mikew123/roborama25_ws/3dprinting/Roborama2025-CamMount.amf

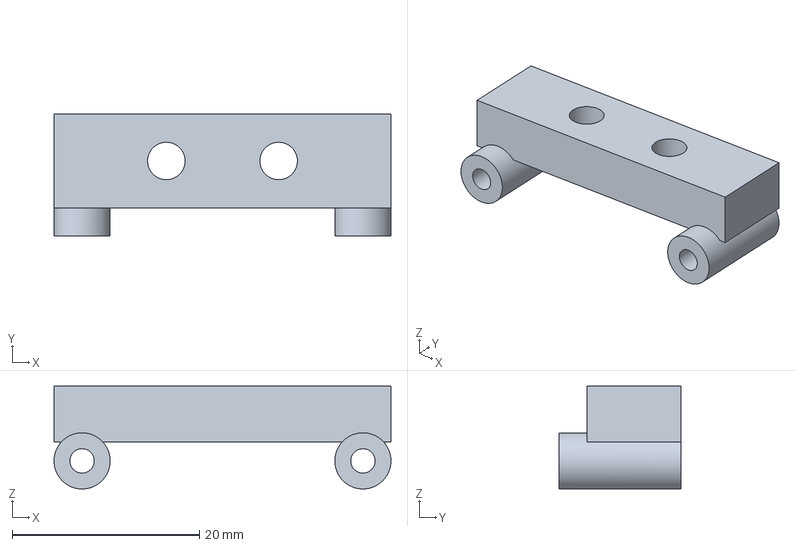
[picture p7: CAD file, 2025-03-17]
3dprinting/Roborama2025-CamMount.amf
36.0 x 13.0 x 11.0 mm
