mikew123/roborama25_ws/3dprinting/Roborama2025-TofL4Mount.amf

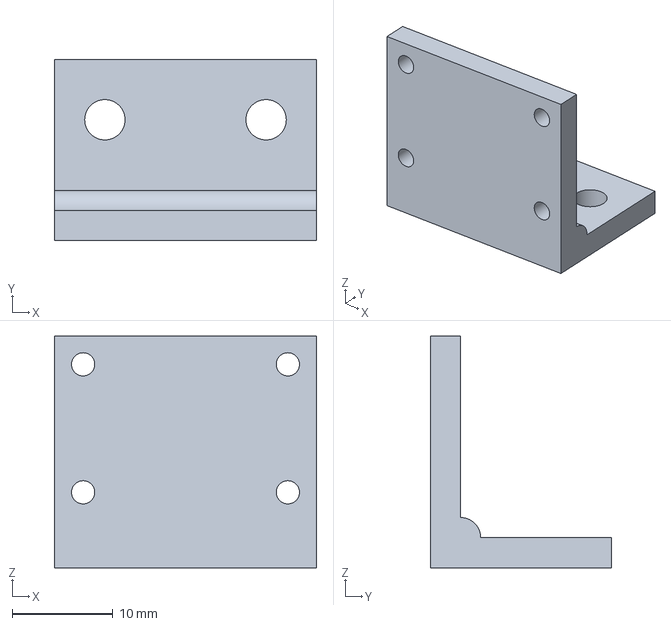
[picture p8: CAD file, 2025-03-17]
3dprinting/Roborama2025-TofL4Mount.amf
26.0 x 18.0 x 23.0 mm
