mikew123/roborama25_ws/3dprinting/Roborama2025-CasterWheelMount.amf

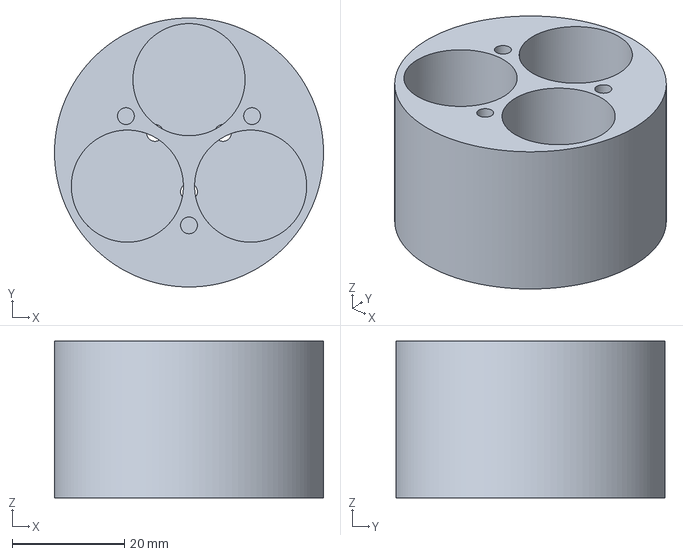
[picture p9: CAD file, 2025-03-17]
3dprinting/Roborama2025-CasterWheelMount.amf
48.0 x 48.0 x 28.0 mm
