mikew123/roborama25_ws/3dprinting/Roborama2025-LidarMount.amf

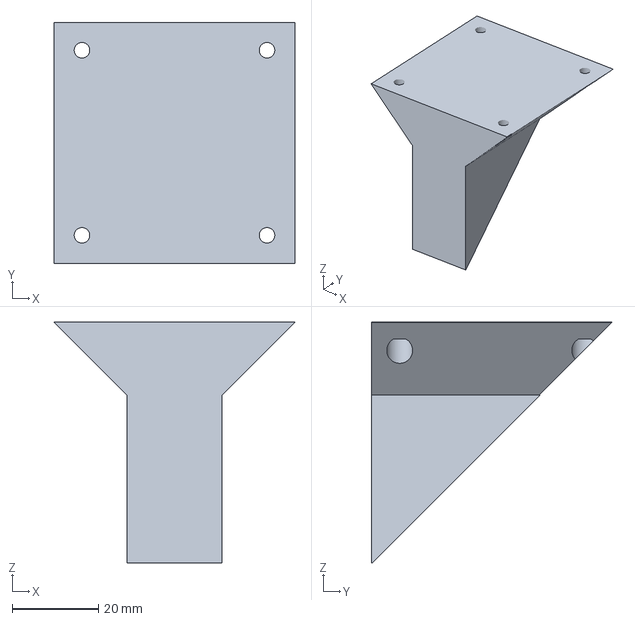
[picture p10: CAD file, 2025-03-17]
3dprinting/Roborama2025-LidarMount.amf
56.0 x 55.9 x 56.0 mm
