mikew123/roborama25_ws/3dprinting/Roborama2025.FCStd

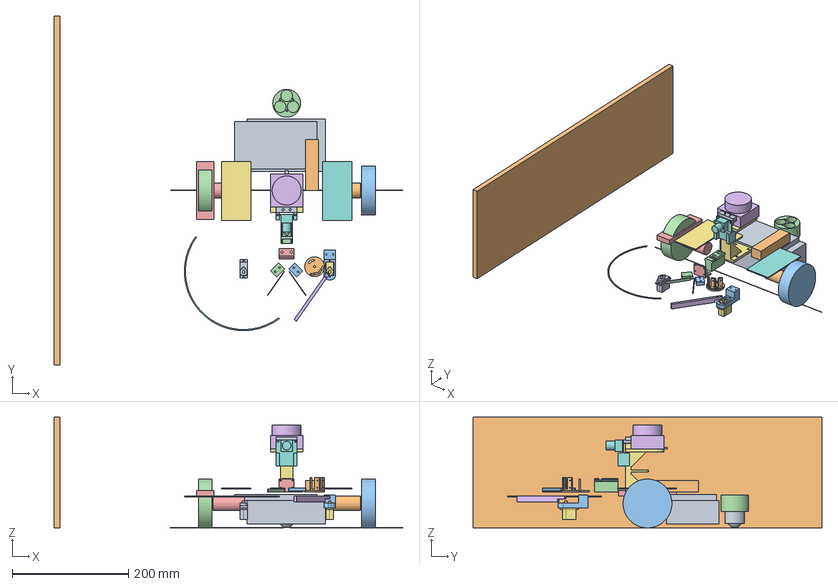
[picture p11: CAD file, 2025-03-17]
3dprinting/Roborama2025.FCStd
600.0 x 600.0 x 190.5 mm
BatteryandVmount
Motor25D20.4:1R
WheelR
WheelL
Motor25D20.4:1L
FloorLevel
PCB2
PCB3
CasterWheel
USBHub
LimitSwR
LimitSwL
LidarC1
ClawServoR
ClawRangeL
ClawServoL
Wall
Lasermount
LidarCamImuMount
Cam
CamMount
TofL5MountL
ServoMount
CasterWheelMount
TofL4Mount
ClawMaster
