mikew123/roborama25_ws/3dprinting/Roborama2025-ClawMaster.amf

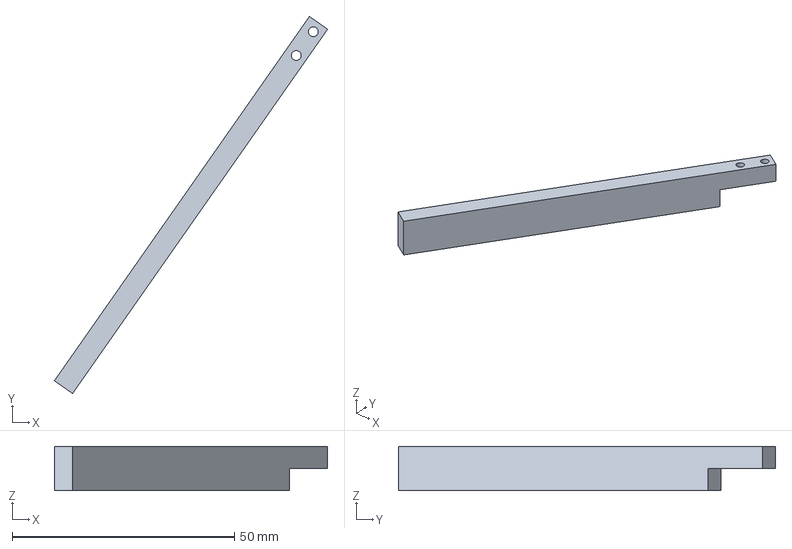
[picture p12: CAD file, 2025-03-17]
3dprinting/Roborama2025-ClawMaster.amf
61.5 x 84.8 x 10.0 mm
