mikew123/roborama25_ws/3dprinting/Roborama2025-ServoMount.amf

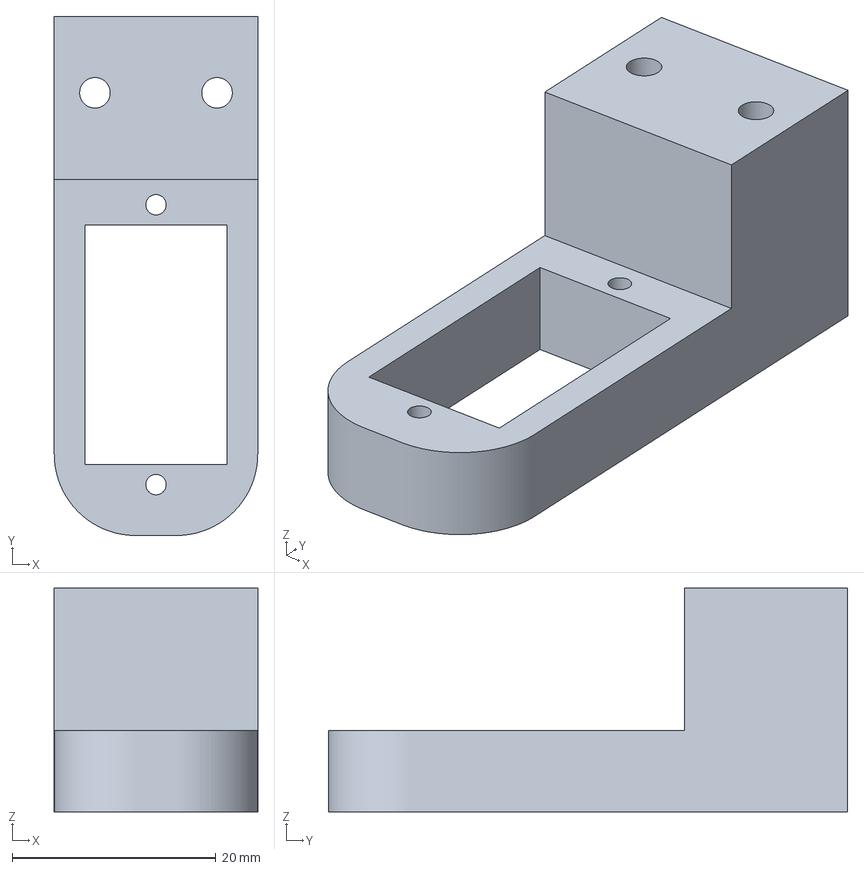
[picture p13: CAD file, 2025-03-17]
3dprinting/Roborama2025-ServoMount.amf
20.0 x 51.0 x 22.0 mm
