mikew123/roborama25_ws/3dprinting/Roborama2025-LidarCamImuMount.amf

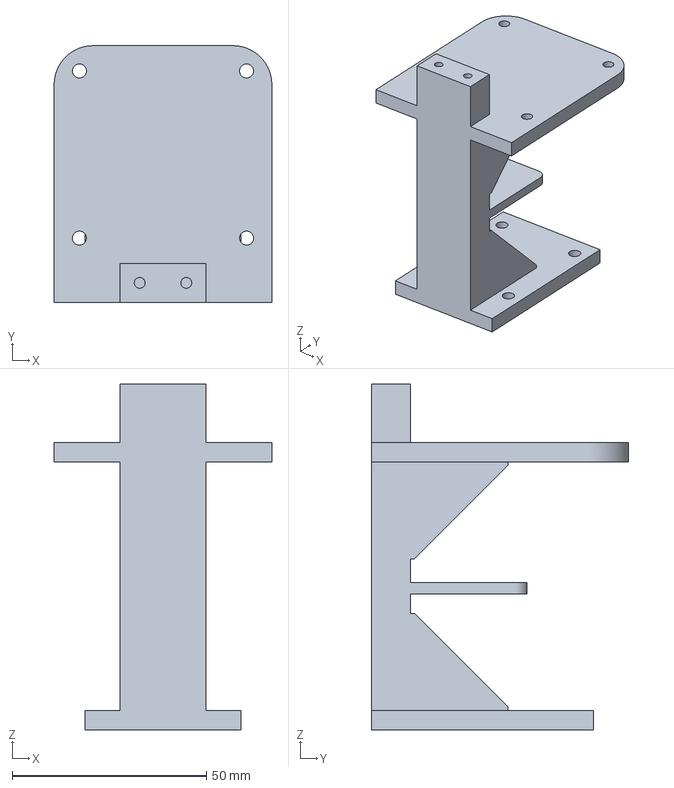
[picture p14: CAD file, 2025-03-17]
3dprinting/Roborama2025-LidarCamImuMount.amf
56.0 x 66.0 x 89.0 mm
