mikew123/roborama25_ws/3dprinting/Roborama2025-TofL5MountL.amf

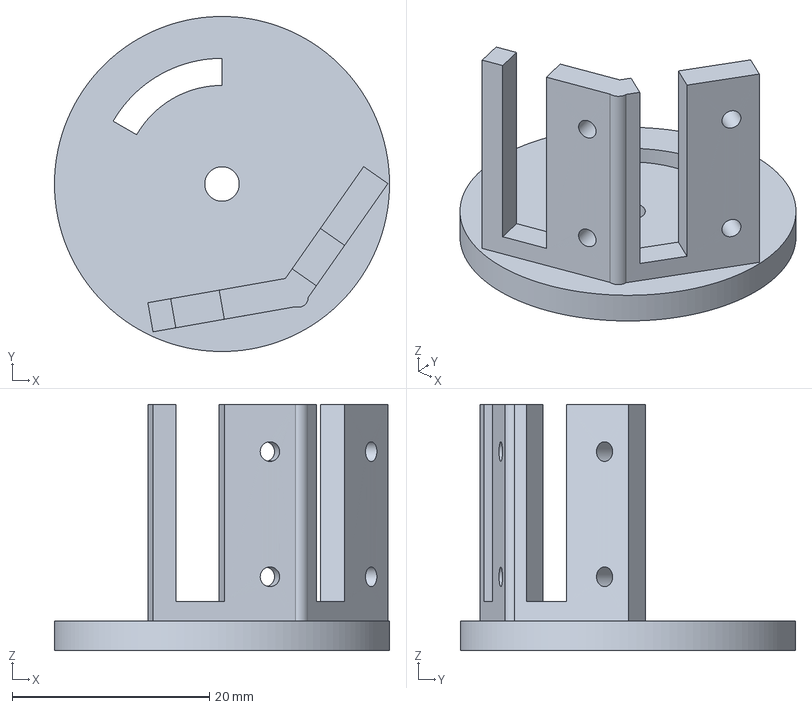
[picture p15: CAD file, 2025-03-17]
3dprinting/Roborama2025-TofL5MountL.amf
34.0 x 34.0 x 25.0 mm
