mikew123/roborama25_ws/3dprinting/Roborama2025-Lasermount.amf

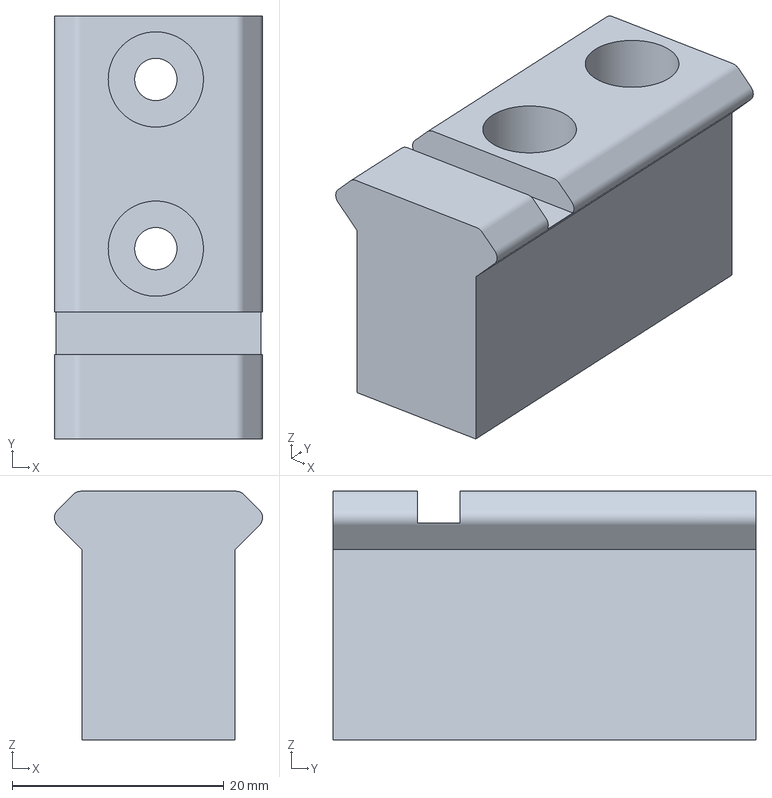
[picture p16: CAD file, 2025-03-17]
3dprinting/Roborama2025-Lasermount.amf
19.7 x 40.0 x 23.5 mm
