mikew123/roborama25_ws/param/roborama25_params.yaml

amcl:
  ros__parameters:
    tf_broadcast: True
    # first_map_only: False
    use_sim_time: False
    alpha1: 0.2
    alpha2: 0.2
    alpha3: 0.2
    alpha4: 0.2
    alpha5: 0.2
    base_frame_id: "base_footprint"
    beam_skip_distance: 0.5
    beam_skip_error_threshold: 0.9
    beam_skip_threshold: 0.3
    do_beamskip: false
    global_frame_id: "map"
    lambda_short: 0.1
    laser_likelihood_max_dist: 2.0
    laser_max_range: 100.0
    laser_min_range: -1.0
    laser_model_type: "likelihood_field"
    max_beams: 60
    max_particles: 2000
    min_particles: 500
    odom_frame_id: "odom"
    pf_err: 0.05
    pf_z: 0.99
    recovery_alpha_fast: 0.1 #0.0
    recovery_alpha_slow: 0.001 #0.0
    resample_interval: 1
    robot_model_type: "nav2_amcl::DifferentialMotionModel"
    save_pose_rate: 0.5
    sigma_hit: 0.2
    # tf_broadcast: true
    transform_tolerance: 1.0
    update_min_a: 0.01 #0.2
    update_min_d: 0.01 #0.25
    z_hit: 0.5
    z_max: 0.05
    z_rand: 0.5
    z_short: 0.05
    scan_topic: scan

amcl_map_client:
  ros__parameters:
    use_sim_time: False

amcl_rclcpp_node:
  ros__parameters:
    use_sim_time: False

bt_navigator:
  ros__parameters:
    use_sim_time: False
    global_frame: map
    robot_base_frame: base_link
    odom_topic: /odom
    default_bt_xml_filename: "navigate_w_replanning_and_recovery.xml"
    bt_loop_duration: 10
    default_server_timeout: 20
    enable_groot_monitoring: True
    groot_zmq_publisher_port: 1666
    groot_zmq_server_port: 1667
    plugin_lib_names:
    - nav2_compute_path_to_pose_action_bt_node
    - nav2_compute_path_through_poses_action_bt_node
    - nav2_follow_path_action_bt_node
    - nav2_back_up_action_bt_node
    - nav2_spin_action_bt_node
    - nav2_wait_action_bt_node
    - nav2_clear_costmap_service_bt_node
    - nav2_is_stuck_condition_bt_node
    - nav2_goal_reached_condition_bt_node
    - nav2_goal_updated_condition_bt_node
    - nav2_initial_pose_received_condition_bt_node
    - nav2_reinitialize_global_localization_service_bt_node
    - nav2_rate_controller_bt_node
    - nav2_distance_controller_bt_node
    - nav2_speed_controller_bt_node
    - nav2_truncate_path_action_bt_node
    - nav2_goal_updater_node_bt_node
    - nav2_recovery_node_bt_node
    - nav2_pipeline_sequence_bt_node
    - nav2_round_robin_node_bt_node
    - nav2_transform_available_condition_bt_node
    - nav2_time_expired_condition_bt_node
    - nav2_distance_traveled_condition_bt_node
    - nav2_single_trigger_bt_node
    - nav2_is_battery_low_condition_bt_node
    - nav2_navigate_through_poses_action_bt_node
    - nav2_navigate_to_pose_action_bt_node
    - nav2_remove_passed_goals_action_bt_node
    - nav2_planner_selector_bt_node
    - nav2_controller_selector_bt_node
    - nav2_goal_checker_selector_bt_node

bt_navigator_rclcpp_node:
  ros__parameters:
    use_sim_time: False

########################## this seems to work OK but bad tuning #################################
# controller_server:
#   ros__parameters:
#     #To use the use_realtime_priority feature, you use set the following inside of /etc/security/limits.conf 
#     # to give userspace access to elevated prioritization permissions: 
#     #<username> soft rtprio 99 <username> hard rtprio 99
#     use_realtime_priority: True

#     use_sim_time: False
#     controller_frequency: 10.0
#     min_x_velocity_threshold: 0.001
#     min_y_velocity_threshold: 0.5
#     min_theta_velocity_threshold: 0.001 
#     failure_tolerance: 0.3
#     progress_checker_plugin: "progress_checker"
#     goal_checker_plugins: ["general_goal_checker"]
#     controller_plugins: ["FollowPath"]

#     # Progress checker parameters
#     progress_checker:
#       plugin: "nav2_controller::SimpleProgressChecker"
#       required_movement_radius: 0.1 #0.0 #0.5
#       movement_time_allowance: 10.0

#     general_goal_checker:
#       stateful: True
#       plugin: "nav2_controller::SimpleGoalChecker"
#       xy_goal_tolerance: 0.25 #0.05 #0.25
#       yaw_goal_tolerance: 0.1 #0.05 #0.25

# #     # DWB parameters
# #     FollowPath:
# #       plugin: "dwb_core::DWBLocalPlanner"
# #       debug_trajectory_details: True
# #       min_vel_x: 0.05
# #       min_vel_y: 0.0
# #       max_vel_x: 0.25
# #       max_vel_y: 0.0
# #       max_vel_theta: 0.25 #0.5
# #       min_speed_xy: 0.1
# #       max_speed_xy: 0.25
# #       min_speed_theta: 0.01
# #       max_speed_theta: 0.05
# #       # Add high threshold velocity for turtlebot 3 issue.
# #       # https://github.com/ROBOTIS-GIT/turtlebot3_simulations/issues/75
# #       acc_lim_x: 0.5 #2.5
# #       acc_lim_y: 0.0
# #       acc_lim_theta: 1.0 #3.2
# #       decel_lim_x: -0.5 #-2.5
# #       decel_lim_y: 0.0
# #       decel_lim_theta: -1.0 #-3.2
# #       vx_samples: 10 #20
# #       vy_samples: 0
# #       vtheta_samples: 20 #40
# #       sim_time: 2.0
# #       linear_granularity: 0.02 #0.05
# #       angular_granularity: 0.02 #0.025
# #       transform_tolerance: 1.0 #0.2
# #       xy_goal_tolerance: 0.05 #0.05
# #       trans_stopped_velocity: 0.25
# #       short_circuit_trajectory_evaluation: True
# #       stateful: True
# # #      critics: ["RotateToGoal", "Oscillation", "BaseObstacle", "GoalAlign", "PathAlign", "PathDist", "GoalDist"]
# #       critics: [
# #         "RotateToGoal", 
# #         "Oscillation", 
# #         "BaseObstacle", 
# #         "GoalAlign", 
# #         "PathAlign", 
# #         "PathDist", 
# #         "GoalDist"
# #         ]
# #       BaseObstacle.scale: 0.02
# #       PathAlign.scale: 32.0
# #       PathAlign.forward_point_distance: 0.1
# #       GoalAlign.scale: 24.0
# #       GoalAlign.forward_point_distance: 0.1
# #       PathDist.scale: 32.0
# #       GoalDist.scale: 24.0
# #       RotateToGoal.scale: 32.0
# #       RotateToGoal.slowing_factor: 5.0
# #       RotateToGoal.lookahead_time: -1.0

#     FollowPath:
#       plugin: "nav2_rotation_shim_controller::RotationShimController"
#       primary_controller: "nav2_regulated_pure_pursuit_controller::RegulatedPurePursuitController"
#       angular_dist_threshold: 0.35 #0.785
#       forward_sampling_distance: 0.5
#       angular_disengage_threshold: 0.15 #0.3925
#       rotate_to_heading_angular_vel: 0.5 #1.8
#       max_angular_accel: 0.5 #3.2
#       simulate_ahead_time: 1.0
#       rotate_to_goal_heading: false
#     # FollowPath:
#     #   plugin: "nav2_regulated_pure_pursuit_controller::RegulatedPurePursuitController"
#       desired_linear_vel: 0.25 #0.5
#       lookahead_dist: 0.6
#       min_lookahead_dist: 0.3
#       max_lookahead_dist: 0.9
#       lookahead_time: 1.5
#       rotate_to_heading_angular_vel: 0.25 #1.8
#       transform_tolerance: 0.1
#       use_velocity_scaled_lookahead_dist: false
#       min_approach_linear_velocity: 0.1
#       approach_velocity_scaling_dist: 0.6
#       use_collision_detection: true
#       max_allowed_time_to_collision_up_to_carrot: 1.0
#       use_regulated_linear_velocity_scaling: true
#       use_fixed_curvature_lookahead: false
#       curvature_lookahead_dist: 0.25
#       use_cost_regulated_linear_velocity_scaling: false
#       regulated_linear_scaling_min_radius: 0.25 #0.9
#       regulated_linear_scaling_min_speed: 0.25
#       use_rotate_to_heading: true
#       allow_reversing: false
#       rotate_to_heading_min_angle: 0.35 #0.785
#       max_angular_accel: 0.5 #3.2
#       max_robot_pose_search_dist: 3.0

# ############### MPPI doesnt seem to work ##############################
# controller_server:
#   ros__parameters:
#     controller_frequency: 10.0 #30.0
#     FollowPath:
#       plugin: "nav2_mppi_controller::MPPIController"
#       time_steps: 56
#       model_dt: 0.1 #0.05
#       batch_size: 2000
#       vx_std: 0.2
#       vy_std: 0.2
#       wz_std: 0.4
#       vx_max: 0.5
#       vx_min: -0.35
#       vy_max: 0.5
#       wz_max: 1.9
#       iteration_count: 1
#       prune_distance: 1.7
#       transform_tolerance: 0.1
#       temperature: 0.3
#       gamma: 0.015
#       motion_model: "DiffDrive"
#       visualize: false
#       TrajectoryVisualizer:
#         trajectory_step: 5
#         time_step: 3
#       AckermannConstraints:
#         min_turning_r: 0.2
#       critics: ["ConstraintCritic", "CostCritic", "GoalCritic", "GoalAngleCritic", "PathAlignCritic", "PathFollowCritic", "PathAngleCritic", "PreferForwardCritic"]
#       ConstraintCritic:
#         enabled: true
#         cost_power: 1
#         cost_weight: 4.0
#       GoalCritic:
#         enabled: true
#         cost_power: 1
#         cost_weight: 5.0
#         threshold_to_consider: 1.4
#       GoalAngleCritic:
#         enabled: true
#         cost_power: 1
#         cost_weight: 3.0
#         threshold_to_consider: 0.5
#       PreferForwardCritic:
#         enabled: true
#         cost_power: 1
#         cost_weight: 5.0
#         threshold_to_consider: 0.5
#       # ObstaclesCritic:
#       #   enabled: true
#       #   cost_power: 1
#       #   repulsion_weight: 1.5
#       #   critical_weight: 20.0
#       #   consider_footprint: false
#       #   collision_cost: 10000.0
#       #   collision_margin_distance: 0.1
#       #   near_goal_distance: 0.5
#       CostCritic:
#         enabled: true
#         cost_power: 1
#         cost_weight: 3.81
#         critical_cost: 300.0
#         consider_footprint: true
#         collision_cost: 1000000.0
#         near_goal_distance: 1.0
#       PathAlignCritic:
#       PathAlignCritic:
#         enabled: true
#         cost_power: 1
#         cost_weight: 14.0
#         max_path_occupancy_ratio: 0.05
#         trajectory_point_step: 3
#         threshold_to_consider: 0.5
#         offset_from_furthest: 20
#         use_path_orientations: false
#       PathFollowCritic:
#         enabled: true
#         cost_power: 1
#         cost_weight: 5.0
#         offset_from_furthest: 5
#         threshold_to_consider: 1.4
#       PathAngleCritic:
#         enabled: true
#         cost_power: 1
#         cost_weight: 2.0
#         offset_from_furthest: 4
#         threshold_to_consider: 0.5
#         max_angle_to_furthest: 1.0
#         forward_preference: true
#       # VelocityDeadbandCritic:
#       #   enabled: true
#       #   cost_power: 1
#       #   cost_weight: 35.0
#       #   deadband_velocities: [0.05, 0.05, 0.05]
#       # TwirlingCritic:
#       #   enabled: true
#       #   twirling_cost_power: 1
#       #   twirling_cost_weight: 10.0

################################ Vector pursuit controller ##############################
controller_server:
  ros__parameters:
    use_sim_time: True
    controller_frequency: 20.0
    min_x_velocity_threshold: 0.001
    min_y_velocity_threshold: 0.5
    min_theta_velocity_threshold: 0.001
    failure_tolerance: 0.3
    progress_checker_plugin: "progress_checker"
    goal_checker_plugins: ["general_goal_checker"]
    controller_plugins: ["FollowPath"]

    # Progress checker parameters
    progress_checker:
      plugin: "nav2_controller::SimpleProgressChecker"
      required_movement_radius: 0.25
      movement_time_allowance: 10.0

    # Goal checker parameters
    general_goal_checker:
      plugin: "nav2_controller::SimpleGoalChecker"
      xy_goal_tolerance: 0.25
      yaw_goal_tolerance: 0.25
      stateful: True
    
    FollowPath:
      plugin: "vector_pursuit_controller::VectorPursuitController"
      k: 5.0
      desired_linear_vel: 0.5
      min_turning_radius: 0.0 #0.25
      lookahead_dist: 1.0
      min_lookahead_dist: 0.5
      max_lookahead_dist: 1.5
      lookahead_time: 1.5
      rotate_to_heading_angular_vel: 0.5
      transform_tolerance: 0.1
      use_velocity_scaled_lookahead_dist: false
      min_linear_velocity: 0.0
      min_approach_linear_velocity: 0.05
      approach_velocity_scaling_dist: 0.5
      max_allowed_time_to_collision_up_to_target: 1.0
      use_collision_detection: true
      use_cost_regulated_linear_velocity_scaling: true
      cost_scaling_dist: 0.5
      cost_scaling_gain: 1.0
      inflation_cost_scaling_factor: 3.0
      use_rotate_to_heading: true
      allow_reversing: false
      rotate_to_heading_min_angle: 0.5
      max_angular_accel: 3.0
      max_linear_accel: 2.0
      max_lateral_accel: 0.2
      max_robot_pose_search_dist: 10.0
      use_interpolation: true
      use_heading_from_path: false
      approach_velocity_scaling_dist: 1.0


controller_server_rclcpp_node:
  ros__parameters:
    use_sim_time: False

local_costmap:
  local_costmap:
    ros__parameters:
      update_frequency: 5.0
      publish_frequency: 2.0
      global_frame: odom
      robot_base_frame: base_link
      use_sim_time: False
      rolling_window: true
      width: 2 #3
      height: 2 #3
      resolution: 0.02 #0.05
      robot_radius: 0.18
      plugins: ["obstacle_layer", "voxel_layer", "inflation_layer"]
      inflation_layer:
        plugin: "nav2_costmap_2d::InflationLayer"
        inflation_radius: 0.20 #0.2
        cost_scaling_factor: 20.0 #3.0
      obstacle_layer:
        plugin: "nav2_costmap_2d::ObstacleLayer"
        enabled: True
        observation_persistence: 1.0
        observation_sources: tofL5L_pcd tofL5R_pcd TofRL_scan TofRC_scan TofRR_scan
        scanl:
        tofL5L_pcd:
          topic: /tofL5L_pcd
          max_obstacle_height: 2.0
          clearing: True
          marking: True
          data_type: "PointCloud2"
          raytrace_max_range: 3.0
          raytrace_min_range: 0.0
          obstacle_max_range: 2.5
          obstacle_min_range: 0.0
        tofL5R_pcd:
          topic: /tofL5R_pcd
          max_obstacle_height: 2.0
          clearing: True
          marking: True
          data_type: "PointCloud2"
          raytrace_max_range: 3.0
          raytrace_min_range: 0.0
          obstacle_max_range: 2.5
          obstacle_min_range: 0.0
        TofRL_scan:
          topic: /TofRL_scan
          max_obstacle_height: 2.0
          clearing: True
          marking: True
          data_type: "LaserScan"
          raytrace_max_range: 1.0
          raytrace_min_range: 0.0
          obstacle_max_range: 0.5
          obstacle_min_range: 0.0
        TofRC_scan:
          topic: /TofRC_scan
          max_obstacle_height: 2.0
          clearing: True
          marking: True
          data_type: "LaserScan"
          raytrace_max_range: 1.0
          raytrace_min_range: 0.0
          obstacle_max_range: 0.5
          obstacle_min_range: 0.0
        TofRR_scan:
          topic: /TofRR_scan
          max_obstacle_height: 2.0
          clearing: True
          marking: True
          data_type: "LaserScan"
          raytrace_max_range: 1.0
          raytrace_min_range: 0.0
          obstacle_max_range: 0.5
          obstacle_min_range: 0.0
      voxel_layer:
        plugin: "nav2_costmap_2d::VoxelLayer"
        enabled: False
        publish_voxel_map: True
        origin_z: 0.0
        z_resolution: 0.05
        z_voxels: 16
        max_obstacle_height: 2.0
        mark_threshold: 0
        observation_sources: scanl scanr 
        scanl:
          topic: /scanl
          max_obstacle_height: 2.0
          clearing: True
          marking: True
          data_type: "LaserScan"
          raytrace_max_range: 3.0
          raytrace_min_range: 0.0
          obstacle_max_range: 2.5
          obstacle_min_range: 0.0
        scanr:
          topic: /scanr
          max_obstacle_height: 2.0
          clearing: True
          marking: True
          data_type: "LaserScan"
          raytrace_max_range: 3.0
          raytrace_min_range: 0.0
          obstacle_max_range: 2.5
          obstacle_min_range: 0.0
      static_layer:
        map_subscribe_transient_local: True
      always_send_full_costmap: True
  local_costmap_client:
    ros__parameters:
      use_sim_time: False
  local_costmap_rclcpp_node:
    ros__parameters:
      use_sim_time: False

global_costmap:
  global_costmap:
    ros__parameters:
      update_frequency: 1.0
      publish_frequency: 1.0
      global_frame: map
      robot_base_frame: base_link
      use_sim_time: False
      robot_radius: 0.18
      resolution: 0.01 #0.05
      track_unknown_space: true
      plugins: ["static_layer", "obstacle_layer", "voxel_layer", "inflation_layer"]
      obstacle_layer:
        plugin: "nav2_costmap_2d::ObstacleLayer"
        enabled: True
        observation_persistence: 1.0
        observation_sources: tofL5L_pcd tofL5R_pcd TofRL_scan TofRC_scan TofRR_scan
        tofL5L_pcd:
          topic: /tofL5L_pcd
          max_obstacle_height: 2.0
          clearing: True
          marking: True
          data_type: "PointCloud2"
          raytrace_max_range: 3.0
          raytrace_min_range: 0.0
          obstacle_max_range: 2.5
          obstacle_min_range: 0.0
        tofL5R_pcd:
          topic: /tofL5R_pcd
          max_obstacle_height: 2.0
          clearing: True
          marking: True
          data_type: "PointCloud2"
          raytrace_max_range: 3.0
          raytrace_min_range: 0.0
          obstacle_max_range: 2.5
          obstacle_min_range: 0.0
        TofRL_scan:
          topic: /TofRL_scan
          max_obstacle_height: 2.0
          clearing: True
          marking: True
          data_type: "LaserScan"
          raytrace_max_range: 1.0
          raytrace_min_range: 0.0
          obstacle_max_range: 0.5
          obstacle_min_range: 0.0
        TofRC_scan:
          topic: /TofRC_scan
          max_obstacle_height: 2.0
          clearing: True
          marking: True
          data_type: "LaserScan"
          raytrace_max_range: 1.0
          raytrace_min_range: 0.0
          obstacle_max_range: 0.5
          obstacle_min_range: 0.0
        TofRR_scan:
          topic: /TofRR_scan
          max_obstacle_height: 2.0
          clearing: True
          marking: True
          data_type: "LaserScan"
          raytrace_max_range: 1.0
          raytrace_min_range: 0.0
          obstacle_max_range: 0.5
          obstacle_min_range: 0.0
      voxel_layer:
        plugin: "nav2_costmap_2d::VoxelLayer"
        enabled: False
        publish_voxel_map: True
        origin_z: 0.0
        z_resolution: 0.05
        z_voxels: 16
        max_obstacle_height: 2.0
        mark_threshold: 0
        observation_sources: scanl scanr
        scanl:
          topic: /scanl
          max_obstacle_height: 2.0
          clearing: True
          marking: True
          data_type: "LaserScan"
          raytrace_max_range: 3.0
          raytrace_min_range: 0.0
          obstacle_max_range: 2.5
          obstacle_min_range: 0.0
        scanr:
          topic: /scanr
          max_obstacle_height: 2.0
          clearing: True
          marking: True
          data_type: "LaserScan"
          raytrace_max_range: 3.0
          raytrace_min_range: 0.0
          obstacle_max_range: 2.5
          obstacle_min_range: 0.0
      static_layer:
        plugin: "nav2_costmap_2d::StaticLayer"
        map_subscribe_transient_local: True
      inflation_layer:
        plugin: "nav2_costmap_2d::InflationLayer"
        cost_scaling_factor: 20.0 #3.0
        inflation_radius: 0.20 #0.18
      always_send_full_costmap: True
  global_costmap_client:
    ros__parameters:
      use_sim_time: False
  global_costmap_rclcpp_node:
    ros__parameters:
      use_sim_time: False

map_server:
  ros__parameters:
    use_sim_time: False
    yaml_filename: "map.yaml"

map_saver:
  ros__parameters:
    use_sim_time: False
    save_map_timeout: 5.0
    free_thresh_default: 0.25
    occupied_thresh_default: 0.65
    map_subscribe_transient_local: True

planner_server:
  ros__parameters:
    expected_planner_frequency: 20.0
    use_sim_time: False
    planner_plugins: ["GridBased"]
    GridBased:
      # plugin: "nav2_navfn_planner/NavfnPlanner"
      # tolerance: 0.1 #0.5
      # use_astar: false
      # allow_unknown: true
      plugin: "nav2_smac_planner/SmacPlanner2D" # In Iron and older versions, "/" was used instead of "::"
      tolerance: 0.125                      # tolerance for planning if unable to reach exact pose, in meters
      downsample_costmap: false             # whether or not to downsample the map
      downsampling_factor: 1                # multiplier for the resolution of the costmap layer (e.g. 2 on a 5cm costmap would be 10cm)
      allow_unknown: true                   # allow traveling in unknown space
      max_iterations: 1000000               # maximum total iterations to search for before failing (in case unreachable), set to -1 to disable
      max_on_approach_iterations: 1000      # maximum number of iterations to attempt to reach goal once in tolerance
      max_planning_time: 2.0                # max time in s for planner to plan, smooth
      cost_travel_multiplier: 1.0 #2.0           # Cost multiplier to apply to search to steer away from high cost areas. Larger values will place in the center of aisles more exactly (if non-`FREE` cost potential field exists) but take slightly longer to compute. To optimize for speed, a value of 1.0 is reasonable. A reasonable tradeoff value is 2.0. A value of 0.0 effective disables steering away from obstacles and acts like a naive binary search A*.
      use_final_approach_orientation: false # Whether to set the final path pose at the goal's orientation to the requested orientation (false) or in line with the approach angle so the robot doesn't rotate to heading (true)
      smoother:
        max_iterations: 1000
        w_smooth: 0.3
        w_data: 0.2
        tolerance: 1.0e-10

planner_server_rclcpp_node:
  ros__parameters:
    use_sim_time: False

recoveries_server:
  ros__parameters:
    costmap_topic: local_costmap/costmap_raw
    footprint_topic: local_costmap/published_footprint
    cycle_frequency: 10.0
    recovery_plugins: ["spin", "backup", "wait"]
    spin:
      plugin: "nav2_recoveries/Spin"
    backup:
      plugin: "nav2_recoveries/BackUp"
    wait:
      plugin: "nav2_recoveries/Wait"
    global_frame: odom
    robot_base_frame: base_link
    transform_timeout: 0.1
    use_sim_time: false
    simulate_ahead_time: 2.0
    max_rotational_vel: 0.5
    min_rotational_vel: 0.1
    rotational_acc_lim: 1.0 #3.2

robot_state_publisher:
  ros__parameters:
    use_sim_time: False

waypoint_follower:
  ros__parameters:
    loop_rate: 200
    stop_on_failure: false
    waypoint_task_executor_plugin: "wait_at_waypoint"
    wait_at_waypoint:
      plugin: "nav2_waypoint_follower::WaitAtWaypoint"
      enabled: True
      waypoint_pause_duration: 200
