mikew123/roborama25_ws/arduino/FrontSensorsRoboRama25/OPT3101.cpp

#include "OPT3101.h"
#include <Wire.h>

static const uint32_t reg80Default = 0x4e1e;

void OPT3101::resetAndWait()
{
  timingGeneratorEnabled = false;

  // Set SOFTWARE_RESET to 1, but don't use writeReg, because the OPT3101 will
  // stop acknowledging after it receives the first register value byte.
  Wire1.beginTransmission(address);
  Wire1.write(0);
  Wire1.write(1);
  lastError = Wire1.endTransmission();
  if (lastError) { return; }

  // Give the sensor some time to get ready.
  delay(5);

  // Wait for INIT_LOAD_DONE to be set, indicating that the OPT3101 is done
  // loading settings from its EEPROM.
  while (!(readReg(3) & (1 << 8)))
  {
    if (getLastError()) { return; }
    delay(1);
  }
}

void OPT3101::writeReg(uint8_t reg, uint32_t value)
{
  Wire1.beginTransmission(address);
  Wire1.write(reg);
  Wire1.write((uint8_t)(value >> 0));
  Wire1.write((uint8_t)(value >> 8));
  Wire1.write((uint8_t)(value >> 16));
  lastError = Wire1.endTransmission();
}

uint32_t OPT3101::readReg(uint8_t reg)
{
  Wire1.beginTransmission(address);
  Wire1.write(reg);
  lastError = Wire1.endTransmission(false); // no stop (repeated start)
  if (lastError)
  {
    return 0;
  }

  uint8_t byteCount = Wire1.requestFrom(address, (uint8_t)3);
  if (byteCount != 3)
  {
    lastError = 50;
    return 0;
  }

  lastError = 0;
  uint32_t value = Wire1.read();
  value |= (uint16_t)Wire1.read() << 8;
  value |= (uint32_t)Wire1.read() << 16;
  return value;
}

void OPT3101::init()
{
  resetAndWait();
  if (getLastError()) { return; }
  configureDefault();
}

void OPT3101::configureDefault()
{
  writeReg(0x89, 7000);      // TG_OVL_WINDOW_START = 7000
  if (getLastError()) { return; }
  writeReg(0x6e, 0x0a0000);  // EN_TEMP_CONV = 1
  if (getLastError()) { return; }
  writeReg(0x50, 0x200101);  // CLIP_MODE_FC = 1
                             // CLIP_MODE_TEMP = 0
                             // CLIP_MODE_OFFSET = 0
  if (getLastError()) { return; }

  // IQ_READ_DATA_SEL = 2: This lets us read "raw" IQ values later.
  uint32_t reg2e = readReg(0x2e);
  if (getLastError()) { return; }
  reg2e = (reg2e & ~((uint32_t)7 << 9)) | (2 << 9);
  writeReg(0x2e, reg2e);
  if (getLastError()) { return; }

  setMonoshotMode();
  if (getLastError()) { return; }
  setFrameTiming(512);
}

void OPT3101::setChannel(uint8_t channel)
{
  if (channel > 2) { channel = OPT3101ChannelAutoSwitch; }

  uint32_t reg2a = readReg(0x2a);
  if (getLastError()) { return; }

  if (channel == OPT3101ChannelAutoSwitch)
  {
    reg2a |= (1 << 0);   // EN_TX_SWITCH = 1
  }
  else
  {
    reg2a &= ~((uint32_t)1 << 0);  // EN_TX_SWITCH = 0
    reg2a = reg2a & ~((uint32_t)3 << 1) | (channel & 3) << 1;
  }

  writeReg(0x2a, reg2a);
}

void OPT3101::nextChannel()
{
  uint8_t nextChannel = channelUsed + 1;
  if (nextChannel > 2) { nextChannel = 0; }
  setChannel(nextChannel);
}

void OPT3101::setBrightness(OPT3101Brightness br)
{
  uint32_t reg2a = readReg(0x2a);
  if (getLastError()) { return; }

  if (br == OPT3101Brightness::Adaptive)
  {
    reg2a |= (uint16_t)1 << 15;  // EN_ADAPTIVE_HDR = 1
  }
  else
  {
    // EN_ADAPTIVE_HDR = 0
    // SEL_HDR_MODE = hdr
    reg2a = reg2a & ~(uint32_t)0x18000 | ((uint32_t)br & 1) << 16;
  }

  writeReg(0x2a, reg2a);
}

void OPT3101::setMonoshotMode()
{
  // MONOSHOT_FZ_CLKCNT = default
  // MONOSHOT_NUMFRAME = 1
  // MONOSHOT_MODE = 3
  writeReg(0x27, 0x26ac07);
  if (getLastError()) { return; }

  // DIS_GLB_PD_OSC = 1
  // DIS_GLB_PD_AMB_DAC = 1
  // DIS_GLB_PD_REFSYS = 1
  // (other fields default)
  writeReg(0x76, 0x000121);
  if (getLastError()) { return; }

  // POWERUP_DELAY = 95
  writeReg(0x26, (uint32_t)95 << 10 | 0xF);
}

void OPT3101::setContinuousMode()
{
  // MONOSHOT_FZ_CLKCNT = default
  // MONOSHOT_NUMFRAME = 1
  // MONOSHOT_MODE = 0
  writeReg(0x27, 0x26ac04);
}

void OPT3101::setFrameTiming(uint16_t subFrameCount)
{
  // Make sure subFrameCount is a power of 2 between 1 and 4096.
  if (subFrameCount < 1 || subFrameCount > 4096 ||
    subFrameCount & (subFrameCount - 1))
  {
    subFrameCount = 4096;
  }

  // Implement equation 6 from sbau310.pdf to calculate
  // XTALK_FILT_TIME CONST, but without floating-point operations.
  uint8_t timeConst = 0;
  while ((subFrameCount << timeConst) < 1024) { timeConst++; }

  uint32_t reg2e = readReg(0x2e);
  if (getLastError()) { return; }
  reg2e = reg2e & ~(uint32_t)0xF00000 | (uint32_t)timeConst << 20;
  writeReg(0x2e, reg2e);
  if (getLastError()) { return; }

  // Set NUM_SUB_FRAMES and NUM_AVG_SUB_FRAMES.
  writeReg(0x9f, (subFrameCount - 1) | (uint32_t)(subFrameCount - 1) << 12);
  if (getLastError()) { return; }

  // Set TG_SEQ_INT_MASK_START and TG_SEQ_INT_MASK_END according to what
  // the OPT3101 datasheet says, but it's probably not needed.
  writeReg(0x97, (subFrameCount - 1) | (uint32_t)(subFrameCount - 1) << 12);

  // Assuming that SUB_VD_CLK_CNT has not been changed, each sub-frame is
  // 0.25 ms.  The +3 is to make sure we round up.
  uint16_t frameTimeMs = (subFrameCount + 3) / 4;

  // Add a ~6% margin in case the OPT3101 clock is running faster.
  frameDelayTimeMs = frameTimeMs + (frameTimeMs + 15) / 16;
}

void OPT3101::enableTimingGenerator()
{
  writeReg(0x80, reg80Default | 1);  // TG_EN = 1
  timingGeneratorEnabled = true;
}

void OPT3101::disableTimingGenerator()
{
  writeReg(0x80, reg80Default);  // TG_EN = 0
  timingGeneratorEnabled = false;
}

void OPT3101::enableDataReadyOutput(uint8_t gpPin)
{
  if (gpPin < 1) { gpPin = 1; }
  if (gpPin > 2) { gpPin = 2; }

  // DIG_GPO_SEL0 = 9 (DATA_RDY)
  uint32_t reg0b = readReg(0x0b);
  reg0b = (reg0b & ~(uint32_t)0xF) | 9;
  writeReg(0x0b, reg0b);
  if (getLastError()) { return; }

  uint32_t reg78 = readReg(0x78);
  switch (gpPin)
  {
  case 1:
    // GPO1_MUX_SEL = 2 (DIG_GPO_0)
    // GPIO1_OBUF_EN = 1
    reg78 = (reg78 & ~((uint32_t)7 << 6)) | (2 << 6) | (1 << 12);
  case 2:
    // GPO2_MUX_SEL = 2 (DIG_GPO_0)
    // GPIO2_OBUF_EN = 1
    reg78 = (reg78 & ~((uint32_t)7 << 9)) | (2 << 9) | ((uint16_t)1 << 15);
  }
  writeReg(0x78, reg78);
  if (getLastError()) { return; }
}

void OPT3101::startSample()
{
  if (!timingGeneratorEnabled) { enableTimingGenerator(); }
  // Set MONOSHOT_BIT to 0 before setting it to 1, as recommended here:
  // https://e2e.ti.com/support/sensors/f/1023/p/756598/2825649#2825649
  writeReg(0x00, 0x000000);
  if (getLastError()) { return; }
  writeReg(0x00, 0x800000);
  startSampleTimeMs = millis();
}

bool OPT3101::isSampleDone()
{
  return (uint16_t)(millis() - startSampleTimeMs) > frameDelayTimeMs;
}

void OPT3101::readOutputRegs()
{
  uint32_t reg08 = readReg(0x08);
  if (getLastError()) { return; }
  uint32_t reg09 = readReg(0x09);
  if (getLastError()) { return; }
  uint32_t reg0a = readReg(0x0a);
  if (getLastError()) { return; }

  channelUsed = reg08 >> 18 & 3;
  if (channelUsed > 2) { channelUsed = 2; }
  brightnessUsed = (OPT3101Brightness)(reg08 >> 17 & 1);

  i = readReg(0x3b);
  if (getLastError()) { return; }
  if (i > 0x7fffff) { i -= 0x1000000; }
  q = readReg(0x3c);
  if (getLastError()) { return; }
  if (q > 0x7fffff) { q -= 0x1000000; }

  amplitude = reg09 & 0xFFFF;  // AMP_OUT
  phase = reg08 & 0xFFFF;  // PHASE_OUT

  // c / (2 * 10 MHz * 0x10000) = 0.22872349395 mm ~= 14990/0x10000
  distanceMillimeters = (int32_t)phase * 14990 >> 16;

  ambient = reg0a >> 2 & 0x3FF;  // AMB_DATA

  temperature = reg0a >> 12 & 0xFFF;  // TMAIN
}

void OPT3101::sample()
{
  startSample();
  if (getLastError()) { return; }
  delay(frameDelayTimeMs);
  readOutputRegs();
}
