mikew123/roborama25_ws/src/sllidar_ros2/src/sllidar_client.cpp

/*
 *  SLLIDAR ROS2 CLIENT
 *
 *  Copyright (c) 2009 - 2014 RoboPeak Team
 *  http://www.robopeak.com
 *  Copyright (c) 2014 - 2022 Shanghai Slamtec Co., Ltd.
 *  http://www.slamtec.com
 *
 */

#include "rclcpp/rclcpp.hpp"
#include "sensor_msgs/msg/laser_scan.hpp"
#include <math.h>

#define RAD2DEG(x) ((x)*180./M_PI)

static void scanCb(sensor_msgs::msg::LaserScan::SharedPtr scan) {
  int count = scan->scan_time / scan->time_increment;
  printf("[SLLIDAR INFO]: I heard a laser scan %s[%d]:\n", scan->header.frame_id.c_str(), count);
  printf("[SLLIDAR INFO]: angle_range : [%f, %f]\n", RAD2DEG(scan->angle_min),
         RAD2DEG(scan->angle_max));

  for (int i = 0; i < count; i++) {
    float degree = RAD2DEG(scan->angle_min + scan->angle_increment * i);
    printf("[SLLIDAR INFO]: angle-distance : [%f, %f]\n", degree, scan->ranges[i]);
  }
}

int main(int argc, char **argv) {
  rclcpp::init(argc, argv);

  auto node = rclcpp::Node::make_shared("sllidar_client");

  auto lidar_info_sub = node->create_subscription<sensor_msgs::msg::LaserScan>(
                        "scan", rclcpp::SensorDataQoS(), scanCb);

  rclcpp::spin(node);

  rclcpp::shutdown();


  return 0;
}
