mikew123/roborama25_ws/(commit log)

2025-03-13 tweaked L5 angle mntOff so there was only 1 of each R+L sensor dots over lap at 1 meter as viewed in Rvix
2025-03-14 offset L4 tof sensor using TF2 "tofL4_link". Apply coding convention that all frames on robot are named "*_link" so "lidar" was changed to "lidar_link"
2025-03-14 Re-coded 8x8 TOF sensors to be in 2 different modules of 2 ea. Each has a transform 'tofL5L_link' and "tofL5R_link" where the postion and pointing angle are set. Calibrated with a can at 1 meter so t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
2025-03-14 updated TF2 frame publish rate to 10Hz
2025-03-15 added arduino code in its own folder
2025-03-15 Put "_" in pdf file name to help insert into README
2025-03-16 Added photos of robot and the front sensor schematic
    [TOF sensors.kicad_sch]
2025-03-17 Added schematics
    [PWR board.kicad_pcb, PWR board.kicad_sch, TOF sensors.kicad_pcb, TOF sensors.kicad_sch, Wheels controller.kicad_pcb, Wheels controller.kicad_sch]
2025-03-17 Fixed claws slowing down at end of closing
    [Wheels controller.kicad_sch]
2025-03-17 Added 3D printing stuff
    [Roborama2025-CamMount.amf, Roborama2025-CasterWheelMount.amf, Roborama2025-ClawMaster.amf, Roborama2025-Lasermount.amf, Roborama2025-LidarCamImuMount.amf, Roborama2025-LidarMount.amf, Roborama2025-ServoMount.amf, Roborama2025-TofL4Mount.amf]
2025-03-17 Updated README with schematic descriptions.
2025-03-28 front sensor has structure of life cycle but has not been fully converted, lifecycle manager operational
2025-03-28 front sensor node converted to lifecycle seems to be OK transitioning
2025-03-29 wheel node is lifecycle coded
2025-03-29 updated lifecycle manager to switch to next state after last state swich is complete
2025-03-30 fixed lc manager wait for state of BOTH nodes to be the expected state
    [roborama25_lifecycle_node_manager.py]
2025-04-12 schematic change
2025-04-12 Added rear sensors OPT3101 to FrontSensors arduino code
2025-04-13 added the 3 rear sensors to publish their range topics
2025-04-13 roborama udf model, link names matching udemy course turtlebot_6can
    [roborama25.urdf]
2025-04-14 Added robot_state_publisher to launch file using the URDF file instead of the TF in the sensor node file which are commented out for now
    [roborama25.urdf]
2025-04-14 wheel controller node now working with robot state TF
    [roborama25.urdf]
2025-04-15 added nav2 bringup to launch file with the turtlebot3 6can param file built earlier. Changed the angular rotation scale factor in the wheel controller to match expected 1m/s
2025-04-16 Fixed wheel dia and spacing - odom does not move as much. added roborama25_controller_node to launch
    [roborama25_controller_node.py, roborama25_params.yaml, roborama25_wheel_controller_node_lc.py]
2025-04-18 Added test/nav2_test code to controller node and put it in a thread controlled by life cycle
2025-04-22 forced amcl localization OFF by setting tf_broadcast=False and transmitting a static map->odom tf. Need to be able to switch localization ON/OFF as needed
2025-04-22 Create a 10mx10m empty map at startup button press the X button to start the test route
2025-04-23 used timer callback for nav2_run instead of thread. Seems to respond to ctrl-C better, no sleep()
2025-04-27 added reverse sensors as obstcals in amcl and limkited range to 0.5m added dprg and home settings and a button on the game controller to select added rear sensor to send a laser scan message for the 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
    [roborama25_controller_node_lc.py, roborama25_front_sensors_node_lc.py, roborama25_params.yaml]
2025-04-27 moved waitUntilNav2Active to lifecycle on_configure. This seems to fix startup issues by waiting for nav2 to startup before configuring the custom code
    [roborama25_controller_node_lc.py]
2025-04-28 enabled the vl53l5 sigma and reflectance filters
2025-04-28 reduce obstacle inflation to 0.20 added controller node debug and single shot when dprg/home buttons pressed Enabled and adjusted fron sensor VL53l% filer values
2025-04-29 removed claw slow down when > 80 and ignoring limit switches since L is not working well
    [WheelControllerRoboRama25.ino]
2025-04-30 in sensor node put try : around sensor string processing to numbers. I was seeing some errors when strings got malformed
    [roborama25_front_sensors_node_lc.py]
2025-04-30 made entries for the sensor messages for 6 can
2025-05-07 tweaked DWB parameters etc lots of changes to the controller adjusted Home 6can arena size disabled obstacle detection while rotating and some 6can movements froze the map->odom TF when amcl TF was d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
    [battery_status_display_node.py, roborama25_controller_node_lc.py, roborama25_params.yaml]
2025-05-09 cleaned up set parameter commented code Attempted some "improvements" in 6can - no so great Tried to get TF multiple times in loop before failing
    [roborama25_controller_node_lc.py, roborama25_params.yaml]
2025-05-09 Adjusted openmv camera vertical angle to get can XY to match the TOF sensors Mucked with 6can - still not great
2025-05-09 fixed getPoseFromTF count issue tweaked log messages
    [roborama25_controller_node_lc.py]
2025-05-10 Added global costmap param setting Seems like it usually fails going to the goal areaand the can dropoff area Added lots of print log debug Increased spin rotation threshold to meeet it easier - seem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
    [roborama25_controller_node_lc.py]
2025-05-10 tweaked amcl params shortened can drop off location, getting close to map edge seems to freak it out! Maybe extend the map further into goal area added initial backup of 50mm to clear the can then ad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
    [roborama25_controller_node_lc.py, roborama25_params.yaml]
2025-05-11 nav2 params: enabled realtime to try to get more priority increased xy-goal tolerance, not sure if it helps worked on quick time. created a simple function to drive forward or reverse performs pretty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
    [roborama25_controller_node_lc.py, roborama25_params.yaml]
2025-05-11 Refactor wheel controller parameters for improved performance and accuracy QT and 4 corner now using simple wheel odom based drive and rotate Still needs some precision tuning
2025-05-14 added a drive and rotate command that uses the timer on the micro. A json message is sent to the wheel node to send the velocities and time ti the wheel micro tweaked the wheel spacing
2025-05-14 added WD command to set wheel diameter. Not debugged, the Linux Arduino IDE didnt have all the librraies.
2025-05-14 adjusted wheel dia and sent a new WD command to the wheel micro with the new dia 0.084 to 0,839 to trim the travel error. Increased the wheel acc/dec from 0.5 to 5.0 to try to reduce the "sticky" err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
    [roborama25_controller_node_lc.py, roborama25_wheel_controller_node_lc.py]
2025-05-15 added rosbags to gitignore Changed nav2 controller to nav2_regulated_pure_pursuit_controller - seems lots better Lowered wheel acceleration limit to 3m/s from 5
2025-05-15 changed planner to smac 2D Tightened up some parameters and reduced speed
    [roborama25_controller_node_lc.py, roborama25_params.yaml]
2025-05-17 slowed nav2 Follow rotation speed Added topic run_state(Int32) for Foxglove debug Fixed checks in gotoCanTF and run_findCan Checked for max range dist in run_approachCan Added extra 0.180 driveDirect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
    [roborama25_controller_node_lc.py, roborama25_front_sensors_node_lc.py, roborama25_params.yaml]
2025-05-18 params.yaml sped up rotation etc created simpler getCanTFOK for can detetction Created roataCanDet which stops when can is detected, now used in simpler run_findCan Added no L5 sensors detect in run_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
2025-05-19 chane L5 sensor data for 6can approach to distance instead of x Used nim sensors distances to approach can
2025-05-21 in sensor node any "bad" data points are published as Inf instead of 0 or -1. Maybe NaN would be better but this works and doesnt crash unintended math functions while carying through the bad data ma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
    [roborama25_controller_node_lc.py, roborama25_front_sensors_node_lc.py]
2025-05-21 moved unused files to a folder wheel controller: removed lots of commented code and some log statments controller: fixed order of 6can goto opening and drop adjusted xy In goto goal opening to get ce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
    [battery_status_display_node.py, robo24_can_xy_node.py, robo24_diynav_node.py, robo24_diyslam_node.py, robo24_imu_serial_node.py, robo24_watch_serial_node.py, roborama25_controller_node.py, roborama25_controller_node_lc.py]
2025-05-22 in controller the "select" button stops navigation by shuting down the node using rclpy.shutdown
2025-05-22 Added new findCanAtGoal state which looks for a can right after dropping a can off and before going to a new location Fixed rotateCanDet which did not stop after timeout
    [roborama25_controller_node_lc.py]
2025-05-23 reduced pursuit minimum turning radius from 0.25 to 0.05 ias attempt to beable to go around obsticals easier. I thing this parameter is mostly for Ackerman mode robots Fixed gotoCanTF timeout and inc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
    [roborama25_controller_node_lc.py, roborama25_params.yaml]
2025-05-24 amcl: persuit set the min turning radius to 0 SMAC planner: reduced cost_travel_multiplier to 1 reduce sensitivity to obsticals controller: modified close can detection to use more sensors and stop t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
2025-05-25 tweaked wheel diameter and spacing at Roborama25 Updated DPRG 4 corner size at Roborama25
